Jo-yongju/ssacurity/docs/steering_without_sensor_troubleshooting.md

# 조향센서 없이 MG996R 조향각을 보정한 트러블슈팅 기록

[← 프로젝트 전체 트러블슈팅 README](troubleshooting/README.md)

## 1. 문제 상황

최종 차량에 MG996R 조향 서보는 장착했지만 실제 바퀴 조향각을 읽을
AS5600 센서는 공간 제약으로 장착하지 못했다. 따라서 STM32는 다음 두 값을
직접 알 수 없었다.

- 서보 PWM에 따라 실제 좌우 앞바퀴가 몇 도 회전했는지
- 주행 중 충격, 기구 유격 또는 타이어 하중 때문에 명령각과 실제 각도가
  달라졌는지

조향센서가 없는 상태에서 단순히 `750~1680 us`를 일정한 각도로 나누면 서보혼과
링크의 비선형성, 좌우 비대칭 및 안티 아커만 특성을 반영할 수 없다. 이 문제를
해결하기 위해 PWM별 좌우 바퀴각을 수동 측정하고, 차량 중심 기준의 등가
조향각을 계산한 뒤 7점 LUT로 저장했다.

이 방식은 실제 센서 피드백을 대체하는 폐루프 제어가 아니다. 현재 차량의
정적인 `명령 조향각 ↔ PWM` 관계를 실측값으로 근사하는 방법이다.

## 2. 하드웨어 및 좌표 규칙

| 항목 | 확정값 |
| --- | --- |
| 서보 PWM | STM32 PB4 / TIM3_CH1 / 50 Hz |
| 서보 전원 | 외부 5 V 강압 전원, STM32와 공통 GND |
| 수동 측정 왼쪽 끝 | 750 us |
| 수동 측정 직진 | 1215 us |
| 수동 측정 오른쪽 끝 | 1680 us |
| 최종 보정 왼쪽 끝 | 766 us |
| 최종 보정 직진 | 1231 us |
| 최종 보정 오른쪽 끝 | 1696 us |
| 휠베이스 `L` | 135 mm (`0.135 m`) |
| 앞 조향축 중심 간 거리 `T` | 85 mm (`0.085 m`) |

차량을 위에서 보고 차량 진행 방향을 기준으로 부호를 정했다.

```text
+조향각: 차량 왼쪽 / 반시계 방향
0도:    차체 중앙선과 평행
-조향각: 차량 오른쪽 / 시계 방향
```

좌회전에서는 양쪽 바퀴각이 모두 양수이고, 우회전에서는 모두 음수다.
안쪽/바깥쪽 바퀴는 부호가 아니라 각도 크기로 구분한다.

## 3. 측정 중 발견한 자동 중앙복귀 문제

초기 `servo-calibrate` 명령은 지정한 펄스를 일정 시간 전송한 뒤 `0 us` 종료
명령을 보냈다. 하지만 STM32 `ControlTask`가 진단 모드를 종료한 직후 일반
조향 명령 `0도`를 다시 적용하면서 서보가 `1215 us` 중앙으로 자동 복귀했다.

```text
진단 펄스 종료
→ TIM3 PWM 정지
→ 일반 조향 제어 재개
→ 목표각 0도
→ 1215 us 출력
→ 바퀴 중앙복귀
```

이 상태에서는 펄스 위치에 선을 긋고 각도를 측정하기 어려웠다.
진단 종료 `0 us`는 진짜 PWM OFF로 처리하고, 다음 명령이 들어오기 전까지
중앙 명령을 재출력하지 않도록 `task_control.c`를 수정했다.

주의할 점은 PWM을 끄면 서보 토크도 사라진다는 것이다. 소프트웨어가 중앙으로
복귀시키지는 않지만 링크의 탄성이나 외력 때문에 바퀴가 움직일 수 있다.

## 4. 수동 측정값

각 PWM에서 차체 진행 방향을 0도로 놓고 왼쪽 앞바퀴와 오른쪽 앞바퀴의 방향을
각각 측정했다.

| PWM | 왼쪽 바퀴각 | 오른쪽 바퀴각 |
| ---: | ---: | ---: |
| 750 | +15도 | +22도 |
| 905 | +10도 | +17도 |
| 1060 | +8도 | +12도 |
| 1215 | 0도 | 0도 |
| 1370 | -8도 | -6도 |
| 1525 | -17도 | -18도 |
| 1680 | -29도 | -26도 |

PWM이 증가할수록 `왼쪽 → 직진 → 오른쪽`으로 단조롭게 변하므로 LUT 입력으로
사용할 수 있다. 다만 좌우 바퀴각 차이와 좌우 최대각 비대칭이 크기 때문에
전체 범위를 하나의 `us/degree` 상수로 환산하면 안 된다.

## 5. 좌우 바퀴각을 등가 중심각으로 변환

왼쪽 바퀴의 횡방향 위치를 `+T/2`, 오른쪽을 `-T/2`로 두었다. 각 바퀴가
요구하는 곡률은 다음과 같이 계산했다.

```text
k_left  = tan(delta_left)  / (L + (T/2) * tan(delta_left))
k_right = tan(delta_right) / (L - (T/2) * tan(delta_right))

k_equivalent = (k_left + k_right) / 2
delta_center = atan(L * k_equivalent)
```

실제 측정값은 완전한 아커만 조건을 만족하지 않으므로 좌우 바퀴가 요구하는
회전 중심이 서로 다르다. 이 경우 실제 주행에서는 타이어 미끄러짐과 기구
변형이 발생하므로, 초기 명령 기반 오도메트리에 사용할 값으로 좌우 곡률의
평균을 사용한 등가 중심각을 선택했다.

| PWM | 왼쪽/오른쪽 바퀴각 | 안티 아커만 | 곡률 불일치 | 등가 중심각 |
| ---: | ---: | ---: | ---: | ---: |
| 750 | +15 / +22도 | +37.8% | 60.8% | +19.55도 |
| 905 | +10 / +17도 | +51.9% | 67.8% | +14.18도 |
| 1060 | +8 / +12도 | +40.0% | 51.4% | +10.27도 |
| 1215 | 0 / 0도 | 0% | 0% | 0도 |
| 1370 | -8 / -6도 | +28.6% | 36.4% | -7.09도 |
| 1525 | -17 / -18도 | -5.7% | 13.7% | -17.56도 |
| 1680 | -29 / -26도 | +10.9% | 45.4% | -28.69도 |

양수 안티 아커만은 바깥쪽 바퀴가 안쪽 바퀴보다 더 많이 꺾였다는 뜻이다.
이 수치는 분석용이며 STM32 제어 명령에 직접 사용하지 않는다.

## 6. 최종 7점 조향 LUT

STM32에는 좌우 바퀴각 원본 대신 `등가 중심각 ↔ PWM`을 저장한다. 수동 측정
후 직진 중심을 맞추기 위해 모든 측정 pulse에 `+16 us` trim을 동일하게
적용했다.

| 등가 중심각 | PWM |
| ---: | ---: |
| +19.55도 | 766 us |
| +14.18도 | 921 us |
| +10.27도 | 1076 us |
| 0도 | 1231 us |
| -7.09도 | 1386 us |
| -17.56도 | 1541 us |
| -28.69도 | 1696 us |

운영 명령 범위는 측정된 전체 비대칭 범위인 `-28.69도 ~ +19.55도`다.
`+`는 왼쪽, `-`는 오른쪽이다. 존재하지 않는 반대편 대칭값을 임의로
외삽하지 않고 각 방향의 실측 끝값에서 제한한다.

## 7. 측정하지 않은 빈 각도의 PWM 계산

측정한 7개 각도만 사용할 수 있는 것이 아니다. 목표각을 포함하는 인접한 두
LUT 지점을 찾고 그 구간 안에서 비례식, 즉 구간별 선형 보간을 수행한다.

두 측정점을 `(angle_0, pulse_0)`, `(angle_1, pulse_1)`이라고 하면:

```text
ratio = (target_angle - angle_0) / (angle_1 - angle_0)

target_pulse =
    pulse_0 + ratio * (pulse_1 - pulse_0)
```

계산 결과는 TIM3이 사용하는 정수 마이크로초 단위로 반올림한다.

### 예시 1: 목표각 +5도

`+5도`는 `0도 ↔ +10.27도` 구간에 있다.

```text
0도      → 1231 us
+10.27도 → 1076 us

ratio = 5 / 10.27
      = 약 0.487

pulse = 1231 + 0.487 * (1076 - 1231)
      = 약 1155.5 us
      → 1156 us
```

### 예시 2: 목표각 -10도

`-10도`는 `-7.09도 ↔ -17.56도` 구간에 있다.

```text
-7.09도  → 1386 us
-17.56도 → 1541 us

ratio = (-10 - -7.09) / (-17.56 - -7.09)
      = 약 0.278

pulse = 1386 + 0.278 * (1541 - 1386)
      = 약 1429 us
```

검증된 중간값 예시는 다음과 같다.

| 목표 중심각 | 계산 PWM |
| ---: | ---: |
| +10도 | 약 1080 us |
| +5도 | 1156 us |
| 0도 | 1231 us |
| -5도 | 약 1340 us |
| -10도 | 1429 us |

전체 범위에 하나의 비례식을 사용하지 않는 이유는 각 구간의 각도 변화량이
서로 다르기 때문이다. 각 인접 지점마다 별도의 기울기를 사용하는 구간별
보간이 실제 링크의 비선형성을 더 잘 반영한다.

측정 범위를 벗어난 목표각은 외삽하지 않는다.

```text
목표각 >= +19.55도 → 766 us
목표각 <= -28.69도 → 1696 us
```

## 8. 실제 코드 반영 위치

| 파일 | 역할 |
| --- | --- |
| `App/Inc/vehicle_config.h` | 7개 등가 중심각/PWM 및 차량 형상값 저장 |
| `App/Src/task_control.c` | 부팅 시 7점 LUT 등록, 진단 종료 상태 처리 |
| `Drivers/BSP/Inc/steering_sensor.h` | `SteeringServoLutPoint`와 LUT API 선언 |
| `Drivers/BSP/Src/steering_sensor.c` | LUT 검증, 구간 탐색, 선형 보간, 끝값 제한 |

기존 3점 보정 API는 다른 진단 코드와의 호환성을 위해 유지했고, 실제 차량
부팅 설정은 7점 LUT API를 사용한다.

`목표 등가 중심각 → 서보 PWM` 변환뿐 아니라, 같은 목표 등가 중심각은 IMU
heading을 사용할 수 없을 때의 model fallback에도 사용한다. 이 각도는 이미
좌우 바퀴 측정값을 합친 중심각이므로 트랙 보정을 중복 적용하지 않고 다음
식을 사용한다.

```text
curvature = tan(center_steering_angle) / wheelbase
yaw_delta = delta_distance * curvature
```

현재 기본 `IMU_ONLY` 모드에서는 이동거리를 엔코더로, heading을 정렬된 BNO085
Game Rotation Vector quaternion yaw로 계산한다. IMU heading이 유효하지 않거나
stale이면 위 model 계산으로 자동 복귀한다. STM32는 `x, y, yaw, distance,
speed, yaw_rate, steering, curvature`를 `0x85 TELEMETRY_ODOMETRY`로 20 Hz
송신한다. 실제 조향센서 측정값이 아님을 `STEERING_ESTIMATED` 상태 비트와
`COMMAND_ESTIMATE` source로 명확히 표시한다.

## 9. 확인 명령

실제 주행 명령 경로에서 빈 각도가 보간되는지 차량을 뒤집고 확인한다.

```powershell
py tools\uart_protocol_test.py drive-test `
  --port COM11 `
  --speed-mm-s 0 `
  --steering-deg 5 `
  --seconds 1.5 `
  --wheels-off-ground
```

`+5도`는 왼쪽 조향이며 계산상 약 `1156 us`가 적용된다.

```powershell
py tools\uart_protocol_test.py drive-test `
  --port COM11 `
  --speed-mm-s 0 `
  --steering-deg -5 `
  --seconds 1.5 `
  --wheels-off-ground
```

`-5도`는 오른쪽 조향이며 계산상 약 `1340 us`가 적용된다.

전체 실측 끝값 왕복 시험:

```powershell
py tools\uart_protocol_test.py steering-full-sweep `
  --port COM11 `
  --cycles 3 `
  --hold-seconds 1.2 `
  --wheels-off-ground
```

명령 기반 오도메트리 부호와 UART 텔레메트리 시험:

```powershell
py tools\uart_protocol_test.py odometry-test `
  --port COM11 `
  --wheels-off-ground
```

## 10. 얻은 교훈과 한계

1. 서보 데이터시트의 일반적인 PWM 범위만으로 실제 바퀴각을 정할 수 없다.
2. 서보혼 각도보다 최종 좌우 바퀴각을 직접 측정해야 차량 곡률을 추정할 수
   있다.
3. 좌우 링크가 비대칭이면 하나의 `us/degree` 값보다 구간별 LUT가 적합하다.
4. 진단 종료 후 일반 제어가 다시 PWM을 출력하는지 상태 전환까지 확인해야
   진짜 PWM OFF를 보장할 수 있다.
5. 센서 없는 LUT는 명령값 추정일 뿐 실제 조향각 피드백이 아니다.
6. 기구 유격, 노면 충격, 하중 및 타이어 미끄러짐은 LUT만으로 감지할 수 없다.
7. 1 m 직선 시험은 1015, 1021, 1018 mm로 평균 절대 오차 1.8%였지만, 전체
   2D pose 정확도까지 검증한 결과는 아니다.
8. 현재 기본 heading은 Game Rotation Vector quaternion yaw이며, 사용할 수
   없을 때 위 LUT 기반 model heading으로 자동 복귀한다.

현재 구조는 조향센서 없이 보정된 LUT를 저속 주행 명령과 model fallback에
사용하는 open-loop 방식이다. 기구 유격이나 외력에 따른 실제 조향각 변화는
직접 관측하지 못한다.
