Jo-yongju/ssacurity/(commit log)

2026-08-10 stm32: establish motor control baseline (#1)
2026-08-10 stm32: add steering and vehicle control
2026-08-10 stm32: add UART communication protocol
2026-08-10 stm32: add ultrasonic safety control
2026-08-10 stm32: add BNO085 IMU support
2026-08-10 stm32: add steering odometry
2026-08-10 stm32: integrate hardware and RTOS tasks
2026-08-11 stm32: reduce idle task load and smooth encoder speed
2026-08-11 stm32: add PID anti-windup build option
2026-08-11 stm32: add linear speed feedforward
2026-08-20 stm32: preserve experimental quaternion odometry
2026-08-27 stm32: enable ultrasonic safety interlock
2026-08-30 Update README
    Removed outdated information regarding steering and safety features.
